MagnusThome/RejsaRubberTrac/3Dprint/images/main housing early wip 1.jpg

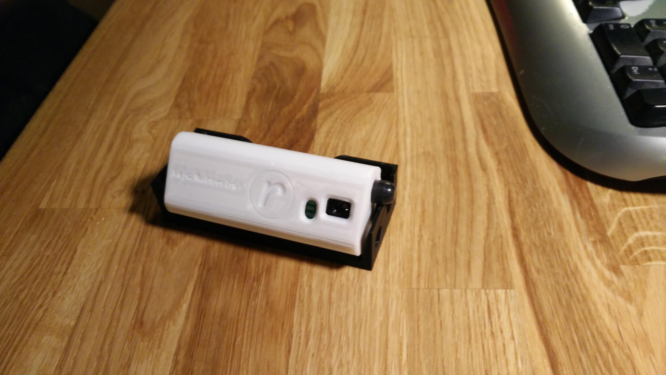
3Dprint/images/main housing early wip 1.jpg
