MagnusThome/RejsaRubberTrac/3Dprint/images/main housing early wip 2.jpg

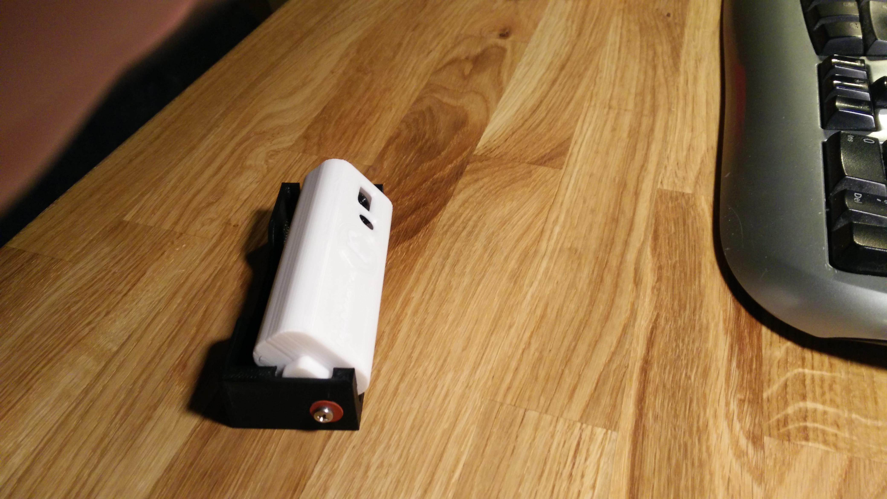
3Dprint/images/main housing early wip 2.jpg
