MagnusThome/RejsaRubberTrac/3Dprint/images/mainhousing.jpg

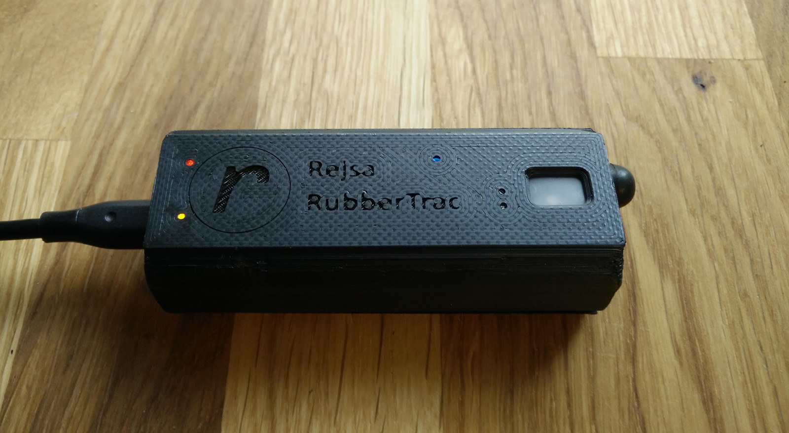
3Dprint/images/mainhousing.jpg
