MagnusThome/RejsaRubberTrac/images/harrys_early_preview.jpg

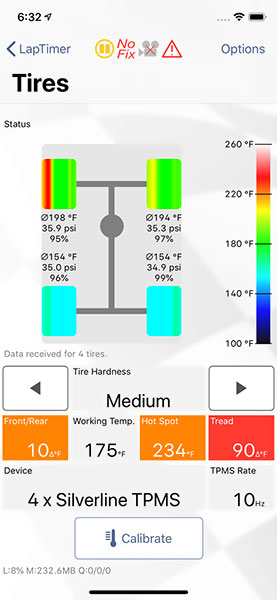
images/harrys_early_preview.jpg
