MagnusThome/RejsaRubberTrac/images/Racechrono beta video.png

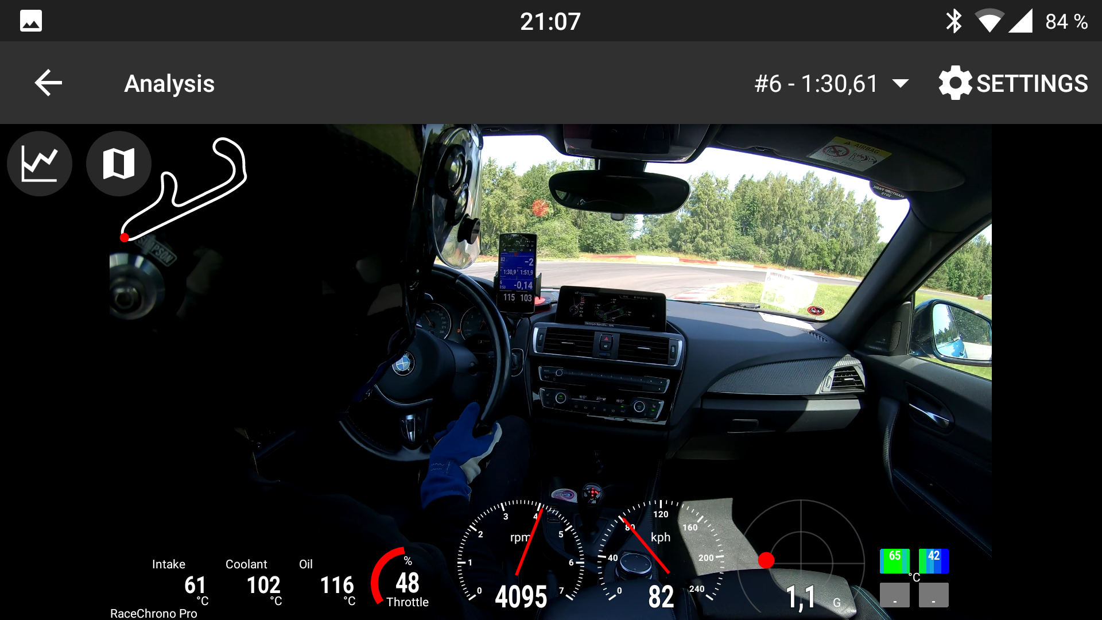
images/Racechrono beta video.png
