MagnusThome/RejsaRubberTrac/images/racechronostresstests.jpg

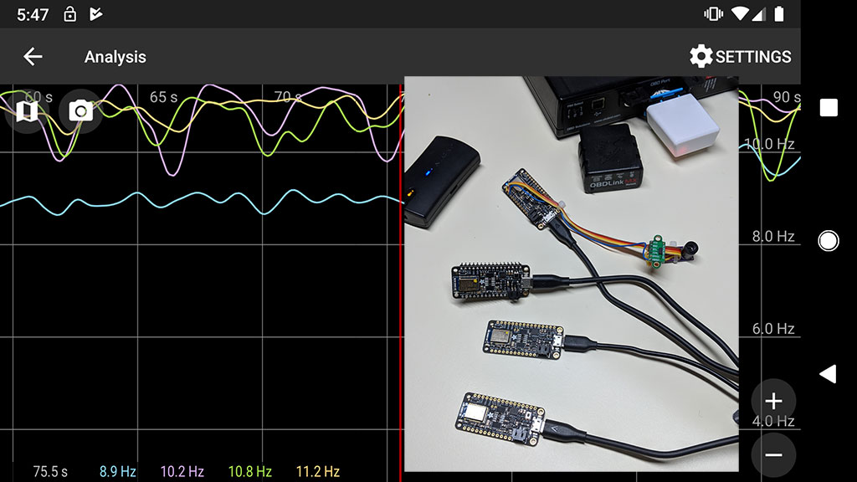
images/racechronostresstests.jpg
