MagnusThome/RejsaRubberTrac/pcb/Component list RejsaRubberTrac board v1.4 (2019-11-19).xlsx

 |  | PCB marking |  |  | Surface mount alternatives
Always needed
 | Adafruit Bluefruit nRF52 CPU/BLE board |  | https://www.mouser.se/ProductDetail/485-3406
 | 1x12 pin header, 2,54 mm | J4 | https://www.mouser.se/ProductDetail/200-TSW11205TS
 | 1x16 pin header, 2,54 mm | J5 | https://www.mouser.se/ProductDetail/200-TSW11605TS
 | 1x6 pin header, 2,54 mm | J1 | https://www.mouser.se/ProductDetail/200-TSW10607TS | For the sandwich mounting of temperature and distance sensor daugther boards.
 | 2x4 pin header, 2,54 mm | J6 | https://www.mouser.se/ProductDetail/200-TSW10407GD
 | Shunt jumpers |  | https://www.mouser.se/ProductDetail/806-SX1100-A | BUY FOUR OF THESE!
 | 1N4007 | D3 | https://www.mouser.se/ProductDetail/750-1N4007-G |  | https://www.mouser.se/ProductDetail/512-S1B
 | 1uF | C4 | https://www.mouser.se/ProductDetail/810-FG28X7R1E105KRT6 |  | https://www.mouser.se/ProductDetail/710-885012106022
 | MLX90621-ESF-BAB temp sensor | U2 | https://www.mouser.se/ProductDetail/482-90621ESFBAB000SP | This is the 60 degree field of view version. There is also a 120 degree version available. NOTE: The temperature sensor from Mouser in the link is without daughter board. You can also buy it with a daughter board from for example: https://www.aliexpress.com/w/wholesale-MLX90621.html?SortType=price_asc&SearchText=MLX90621 https://eckstein-shop.de/GY-906LLC-BAB-IR-Array-Temperature-Sensor-Module
Power switch |  |  |  | If you run your sensors without battery and use the car's 12V which is switched off itself you really don't need a power switch. But can still be useful to reset the device of course
 | PN12SHNA03QE (switch) | S1 | https://www.mouser.se/ProductDetail/611-PN12SHNA03QE
 | rubber seal |  | https://www.mouser.se/ProductDetail/608-1211-5
 | button top |  | https://www.mouser.se/ProductDetail/611-G003A
12V power
 | MC7805BDTRKG | U1 | https://www.mouser.se/ProductDetail/863-MC7805BDTRKG | Actually a surface mount version but it's pretty big so not hard to solder. Benefit is it's thin and fits between the boards.
 | Shottky | D1 | https://www.mouser.se/ProductDetail/583-1S40-T |  | https://www.mouser.se/ProductDetail/511-STPS1L30A
 | 1N4007 | D2 | https://www.mouser.se/ProductDetail/750-1N4007-G |  | https://www.mouser.se/ProductDetail/512-S1B
 | 1uF | C1 | https://www.mouser.se/ProductDetail/810-FG28X7R1E105KRT6 |  | https://www.mouser.se/ProductDetail/710-885012106022
 | 1uF | C2 | https://www.mouser.se/ProductDetail/810-FG28X7R1E105KRT6 |  | https://www.mouser.se/ProductDetail/710-885012106022
Distance sensor
 | VL53L0XV2 / VL53L0CX | U3 | https://www.ebay.com/sch/i.html?_nkw=vl53l0xv2&_sop=15 or https://www.aliexpress.com/w/wholesale-vl53l0xv2.html?SortType=price_asc&SearchText=vl53l0xv2 | Beware: There is now a version of this board that looks the same but that has moved around what is connected to what pin. The order of pins (look carefully at the product picture on the page where you order) must be: - VIN - GND - SCL - SDA - GPIO - XSHUT
Different battery choices
 | Flat Li-Po rechargeable battery (JSP-PH 2.0 mm connector) |  | https://www.ebay.com/sch/i.html?_nkw=3.7V+lipo+battery+JST-PH+2.0&_sop=15 | The size "503035" fits in the 3D-printed housing but is a bit big capacity and size wise lasting 24 hours straight (500mAh). So you can choose smaller if you want.
 | 1x2 pin header, 2,54 mm | J2 | https://www.mouser.se/ProductDetail/200-TSW10207GS | Only needed if you have a battery with a 2.54 mm connector plug instead if the already present JST-PH 2.0 mm one.
 | 1x2 pin header, 1,27 mm | J3 | https://www.mouser.se/ProductDetail/200-FTS10201FS | Only needed if you have a battery with a 1.27 mm connector plug instead if the already present JST-PH 2.0 mm one.
 | Using AA or AAA battery size Li-Ions (not actual 1,5V batteries!!) instead of the above flat Li-Po battery one takes a lot of space on the rear side of the board
 | Li-ion battery holder AA | on rear side | https://www.mouser.se/ProductDetail/534-1087 | Only needed if you want to use a AA size Li-Ion rechargeable battery
 | Li-ion battery holder AAA | on rear side | https://www.mouser.se/ProductDetail/534-1075 | Only needed if you want to use a AAA size Li-Ion rechargeable battery
 | AAA size Li-ion rechargeable battery |  | https://www.ebay.com/sch/i.html?_nkw=li-ion+3.7V+aaa+10440&_sop=15
 | AA size Li-ion rechargeable battery |  | https://www.ebay.com/sch/i.html?_nkw=li-ion+3.7V+aa+14500&_sop=15
Changes
1.1 | Published on Github
1.2 | Added link to temperature sensors WITH daughter board
1.3 | Corrected Mouser part number for switch rubber seal
1.4 | Added warning about distance sensor board with wrong board pinout
