MagnusThome/RejsaRubberTrac/3Dprint/printables/Main Housing (CONE for dist. sens.).step

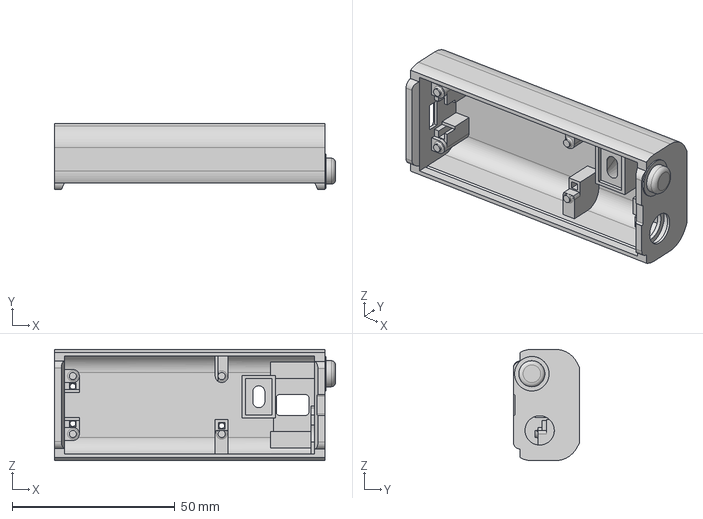
[picture p47: CAD file, 2023-02-16]
3Dprint/printables/Main Housing (CONE for dist. sens.).step
86.3 x 20.4 x 34.2 mm
