MagnusThome/RejsaRubberTrac/3Dprint/printables/Main Housing (ALT. temp sensor mounting).step

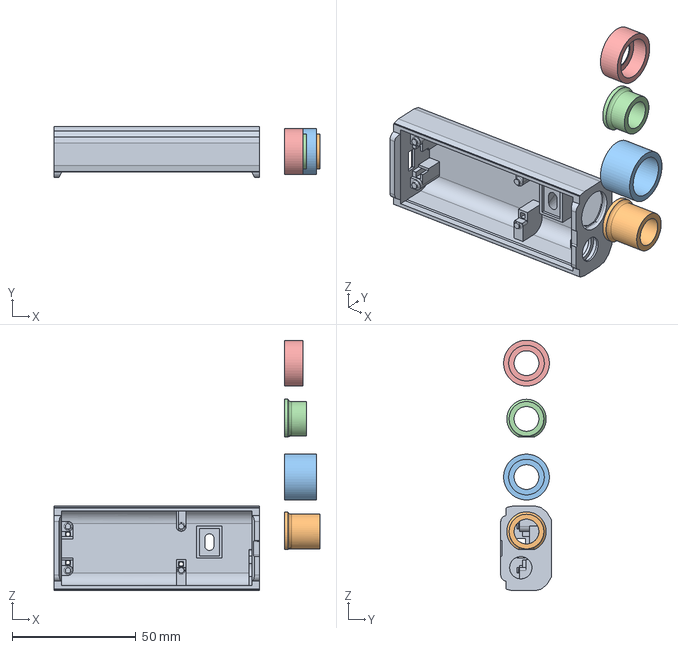
[picture p48: CAD file, 2023-02-16]
3Dprint/printables/Main Housing (ALT. temp sensor mounting).step
107.4 x 20.4 x 101.1 mm
