MagnusThome/RejsaRubberTrac/3Dprint/printables/Main Housing Lid LEFT REAR.stl

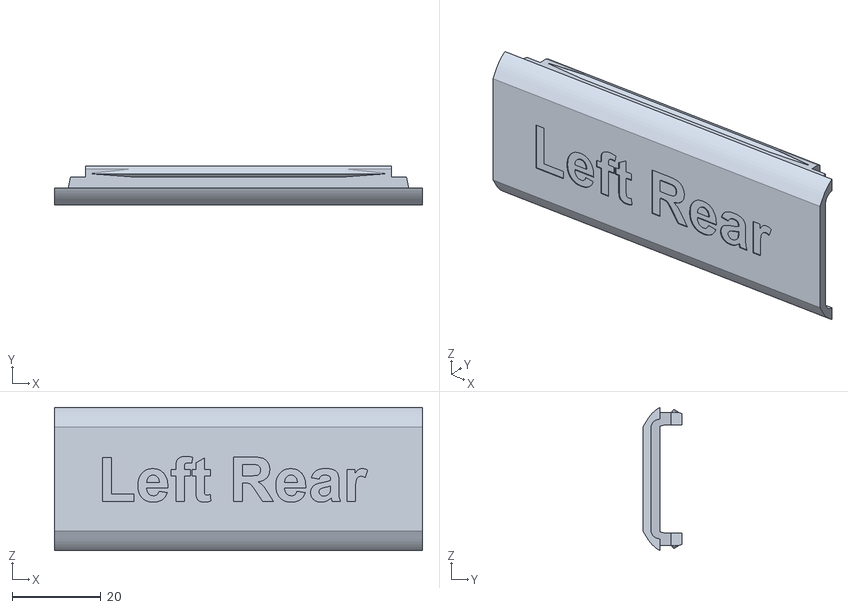
[picture p49: CAD file, 2020-07-22]
3Dprint/printables/Main Housing Lid LEFT REAR.stl
83.0 x 8.90 x 32.4
