MagnusThome/RejsaRubberTrac/3Dprint/printables/Main Housing Lid NO TEXT.stl

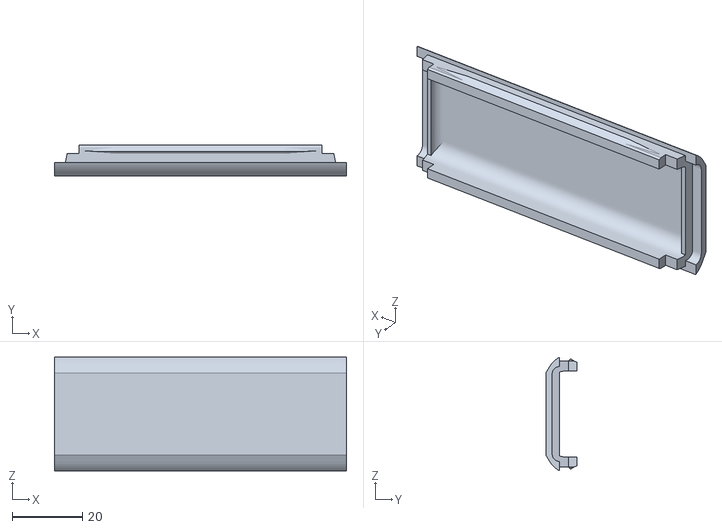
[picture p50: CAD file, 2020-07-22]
3Dprint/printables/Main Housing Lid NO TEXT.stl
83.0 x 8.90 x 32.4
