MagnusThome/RejsaRubberTrac/3Dprint/printables/Main Housing (ALT. temp sensor mounting) Base.stl

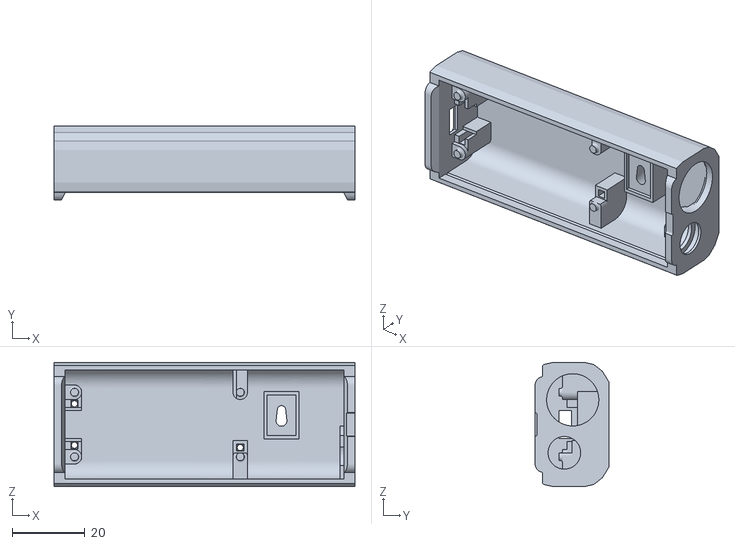
[picture p51: CAD file, 2019-10-04]
3Dprint/printables/Main Housing (ALT. temp sensor mounting) Base.stl
83.0 x 20.4 x 34.2
