MagnusThome/RejsaRubberTrac/3Dprint/printables/Main Housing (ALT. temp sensor mounting) Sensor mountings.stl

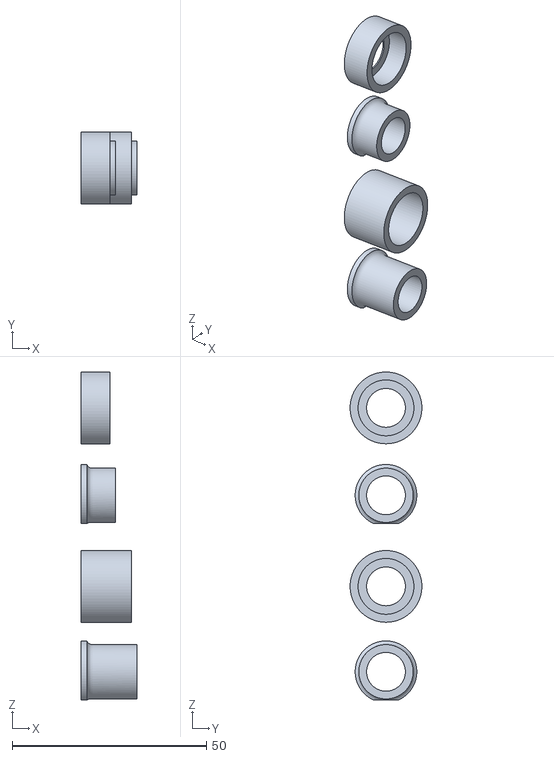
[picture p52: CAD file, 2019-09-29]
3Dprint/printables/Main Housing (ALT. temp sensor mounting) Sensor mountings.stl
14.4 x 18.5 x 84.5
