MagnusThome/RejsaRubberTrac/3Dprint/printables/Main Housing USB Lid.stl

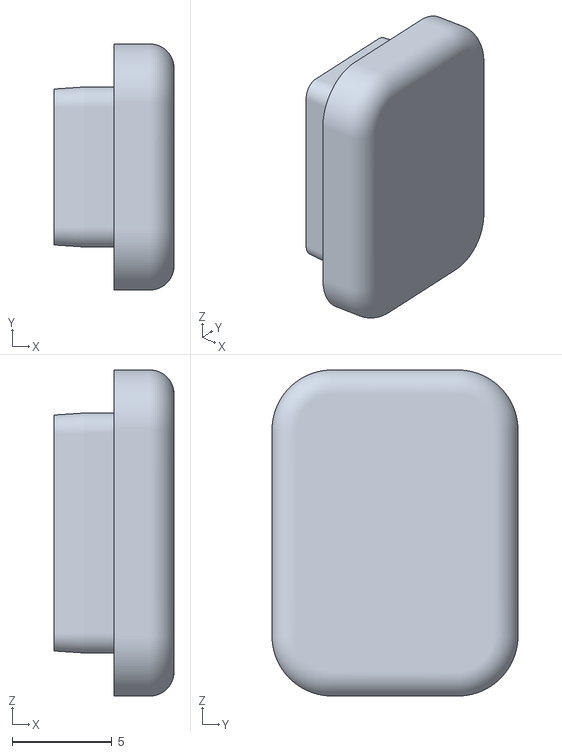
[picture p53: CAD file, 2019-03-17]
3Dprint/printables/Main Housing USB Lid.stl
6.00 x 12.3 x 16.3
