MagnusThome/RejsaRubberTrac/3Dprint/printables/Snap-in holder (Inner fender for BMW M2) v12.step

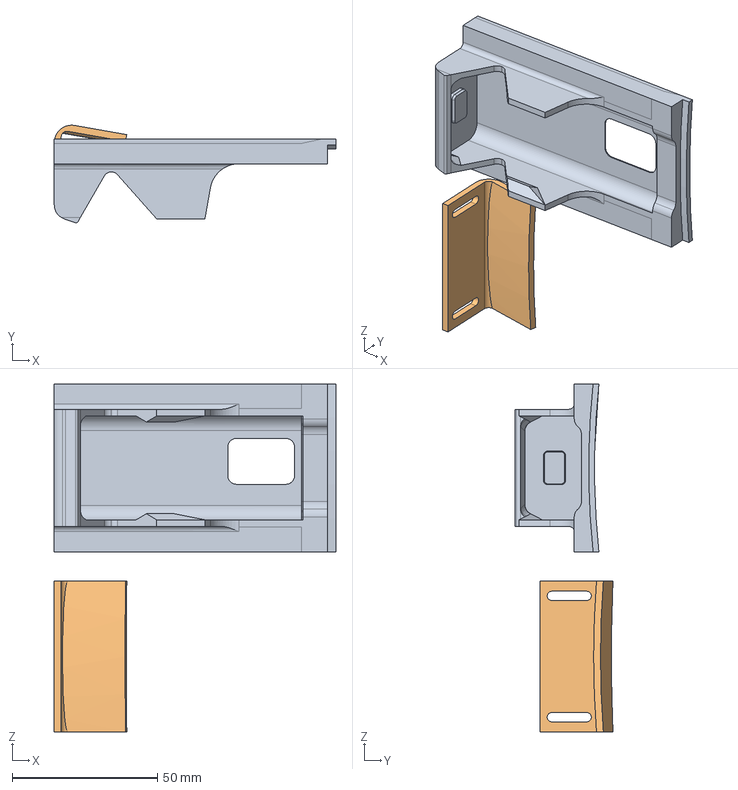
[picture p54: CAD file, 2020-07-28]
3Dprint/printables/Snap-in holder (Inner fender for BMW M2) v12.step
97.0 x 33.6 x 119.9 mm
