MagnusThome/RejsaRubberTrac/3Dprint/printables/Snap-in holder (Inner fender for BMW M2) Bracket.stl

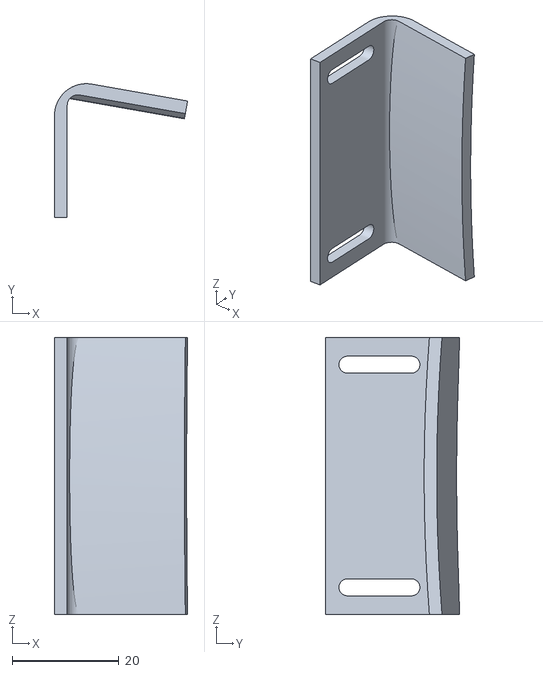
[picture p55: CAD file, 2020-07-28]
3Dprint/printables/Snap-in holder (Inner fender for BMW M2) Bracket.stl
25.0 x 25.1 x 52.0
