MagnusThome/RejsaRubberTrac/3Dprint/printables/Snap-in holder (Inner fender for BMW M2) Base.stl

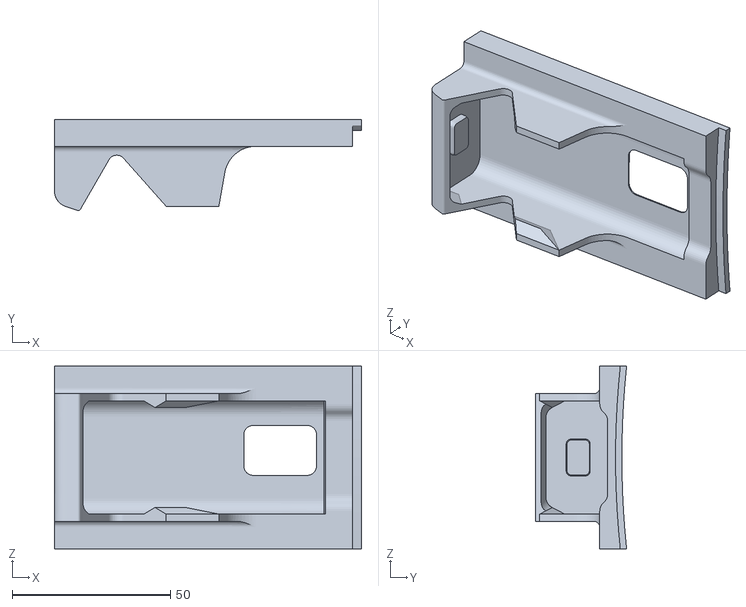
[picture p56: CAD file, 2020-07-28]
3Dprint/printables/Snap-in holder (Inner fender for BMW M2) Base.stl
97.0 x 28.8 x 57.8
