MagnusThome/RejsaRubberTrac/3Dprint/printables/Snap-in holder (Under Car).stl

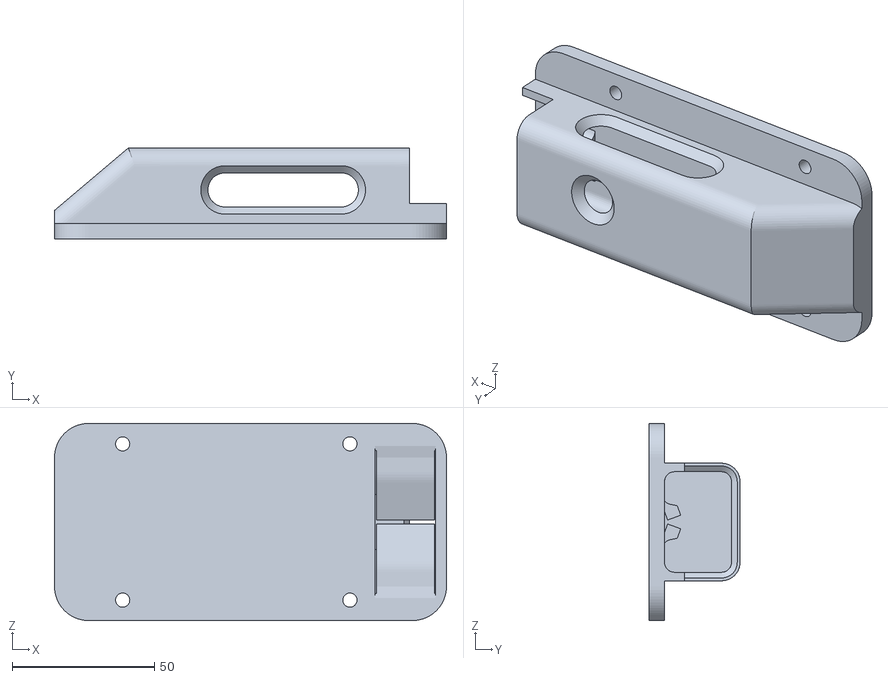
[picture p57: CAD file, 2019-10-05]
3Dprint/printables/Snap-in holder (Under Car).stl
138.0 x 32.1 x 69.4
