MagnusThome/RejsaRubberTrac/3Dprint/printables/Minisensor v2.step

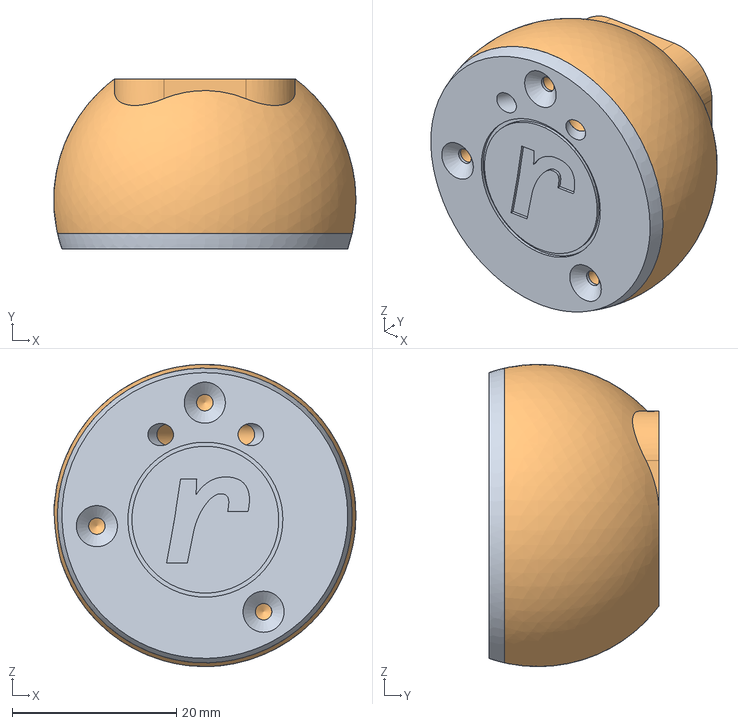
[picture p58: CAD file, 2019-10-02]
3Dprint/printables/Minisensor v2.step
36.8 x 20.8 x 36.8 mm
