MagnusThome/RejsaRubberTrac/3Dprint/printables/Snap-in holder (Hinged) v17.step

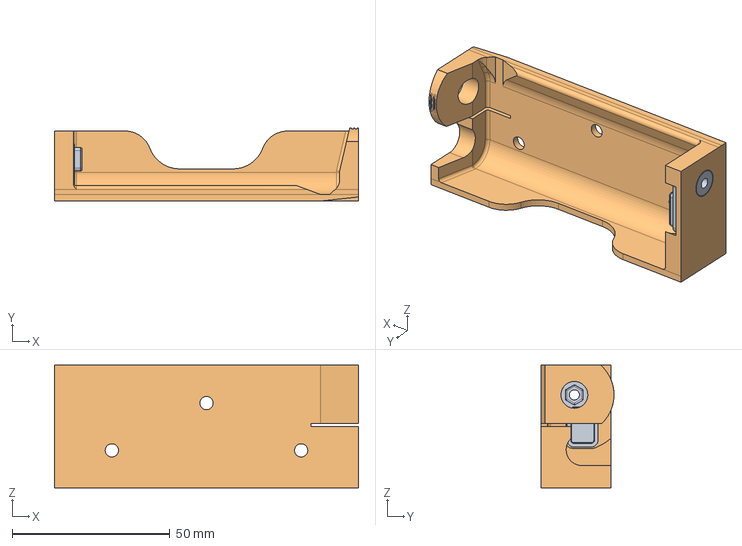
[picture p59: CAD file, 2019-10-02]
3Dprint/printables/Snap-in holder (Hinged) v17.step
96.3 x 23.2 x 38.9 mm
