MagnusThome/RejsaRubberTrac/3Dprint/printables/Temperature Sensor Mounting Spacer 5,5mm.stl

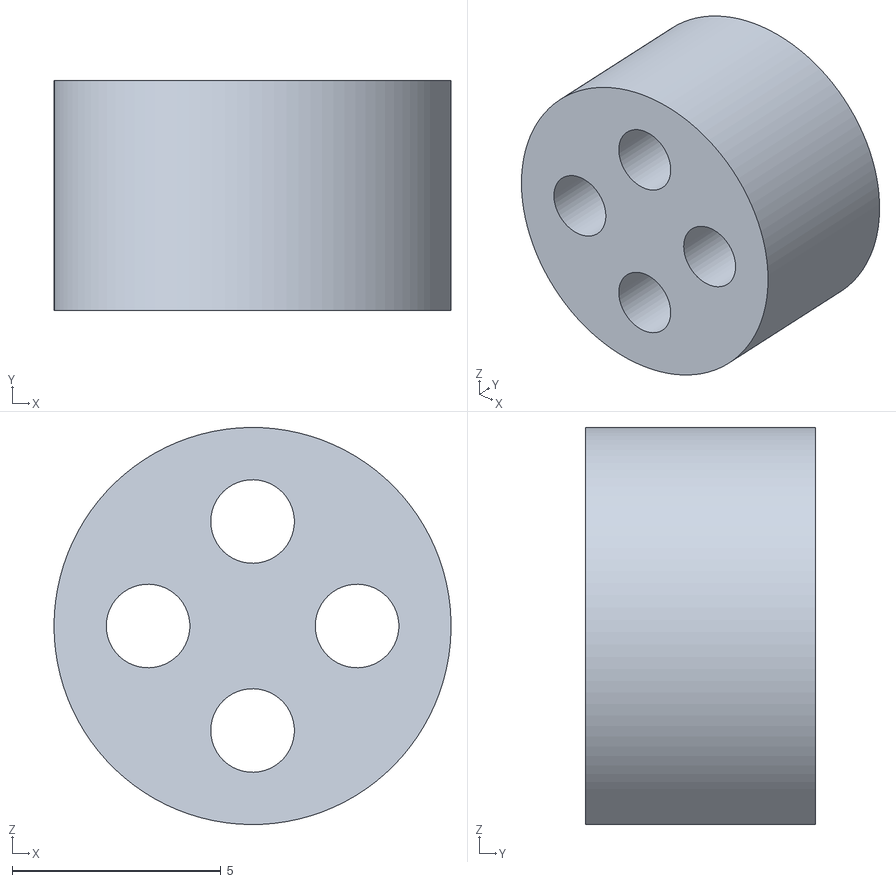
[picture p60: CAD file, 2019-09-28]
3Dprint/printables/Temperature Sensor Mounting Spacer 5,5mm.stl
9.50 x 5.50 x 9.50
