MagnusThome/RejsaRubberTrac/3Dprint/printables/Snap-in holder (Hinged) Base.stl

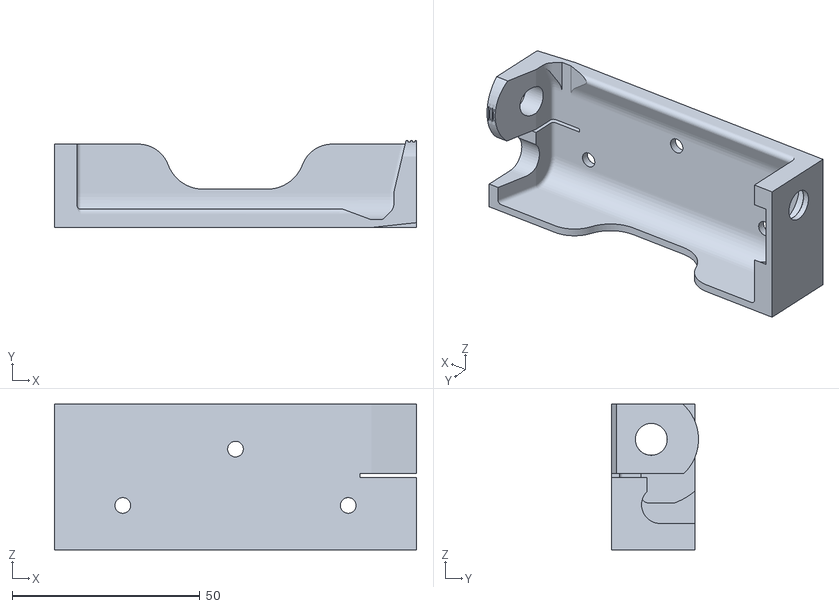
[picture p61: CAD file, 2019-09-27]
3Dprint/printables/Snap-in holder (Hinged) Base.stl
96.4 x 23.2 x 38.9
