MagnusThome/RejsaRubberTrac/3Dprint/printables/Snap-in holder (Hinged) Hinge.stl

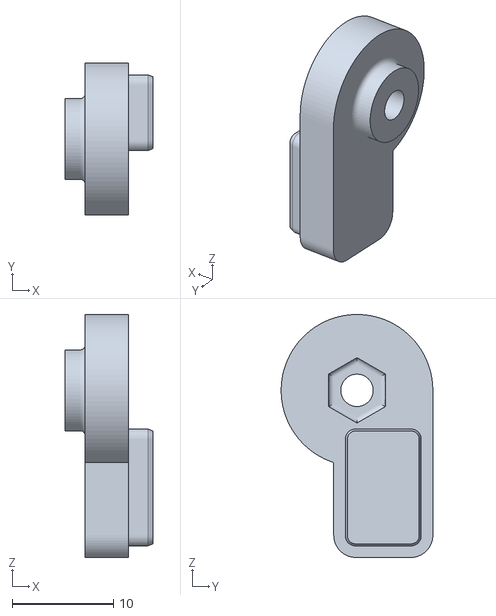
[picture p62: CAD file, 2019-09-27]
3Dprint/printables/Snap-in holder (Hinged) Hinge.stl
8.70 x 15.0 x 24.0
