MagnusThome/RejsaRubberTrac/3Dprint/printables/Carrying Case.stl

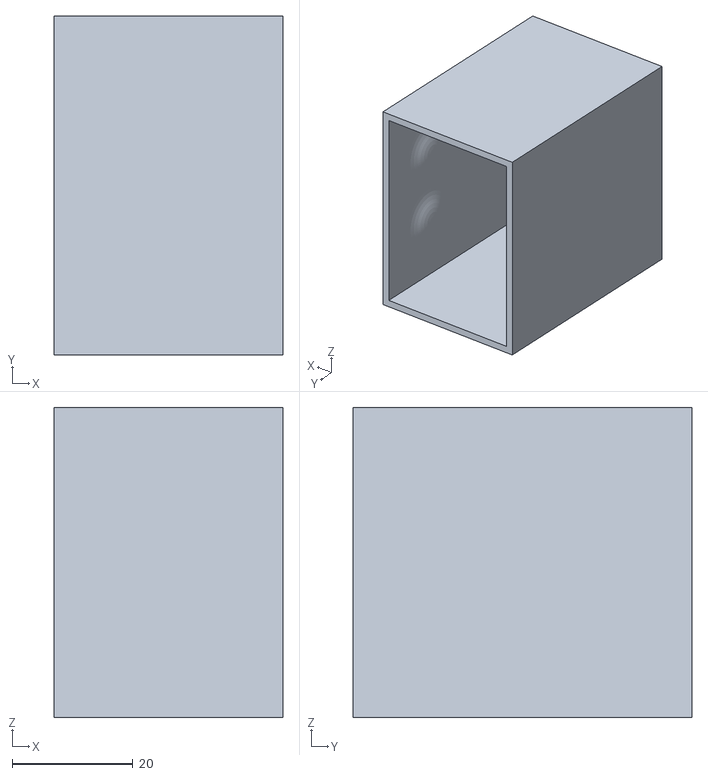
[picture p63: CAD file, 2019-08-29]
3Dprint/printables/Carrying Case.stl
37.9 x 56.2 x 51.4
