MagnusThome/RejsaRubberTrac/3Dprint/printables/Minisensor Holder Ring.stl

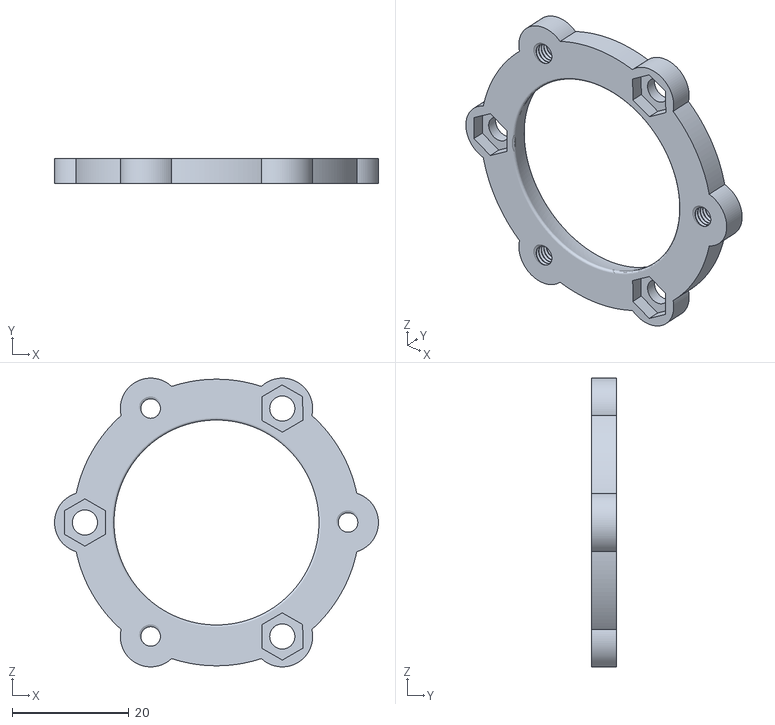
[picture p64: CAD file, 2019-04-29]
3Dprint/printables/Minisensor Holder Ring.stl
55.4 x 4.20 x 49.4
