MagnusThome/RejsaRubberTrac/3Dprint/printables/Minisensor Base.stl

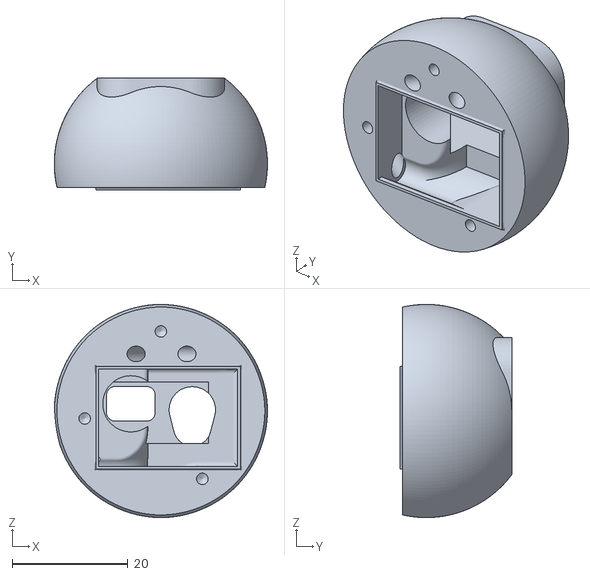
[picture p65: CAD file, 2019-04-29]
3Dprint/printables/Minisensor Base.stl
36.8 x 19.3 x 36.8
