MagnusThome/RejsaRubberTrac/3Dprint/printables/Minisensor Lid.stl

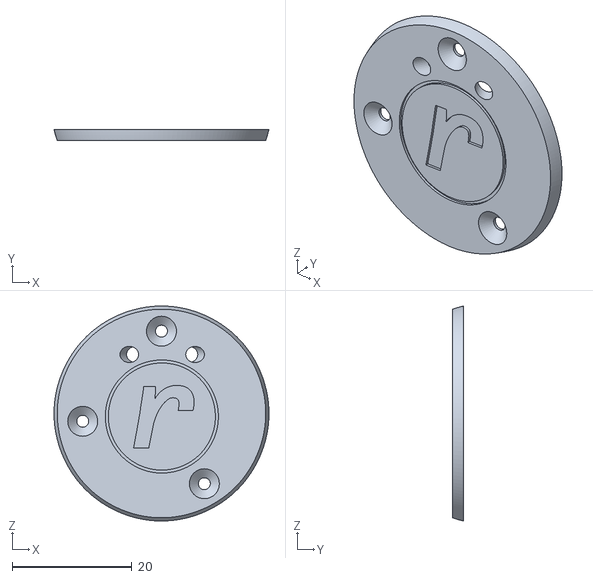
[picture p66: CAD file, 2019-04-29]
3Dprint/printables/Minisensor Lid.stl
35.9 x 1.90 x 35.9
