MagnusThome/RejsaRubberTrac/3Dprint/printables/Temperature Sensor Mounting Spacer 10mm.stl

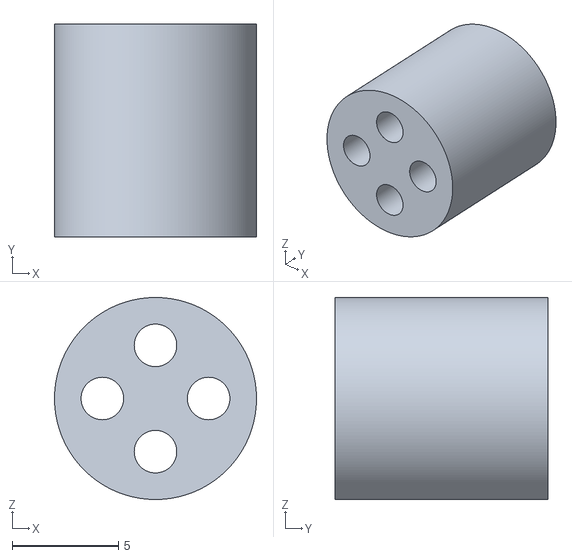
[picture p67: CAD file, 2019-03-13]
3Dprint/printables/Temperature Sensor Mounting Spacer 10mm.stl
9.50 x 10.0 x 9.50
