MagnusThome/RejsaRubberTrac/3Dprint/printables/Temperature Sensor Mounting Spacer 3,5mm.stl

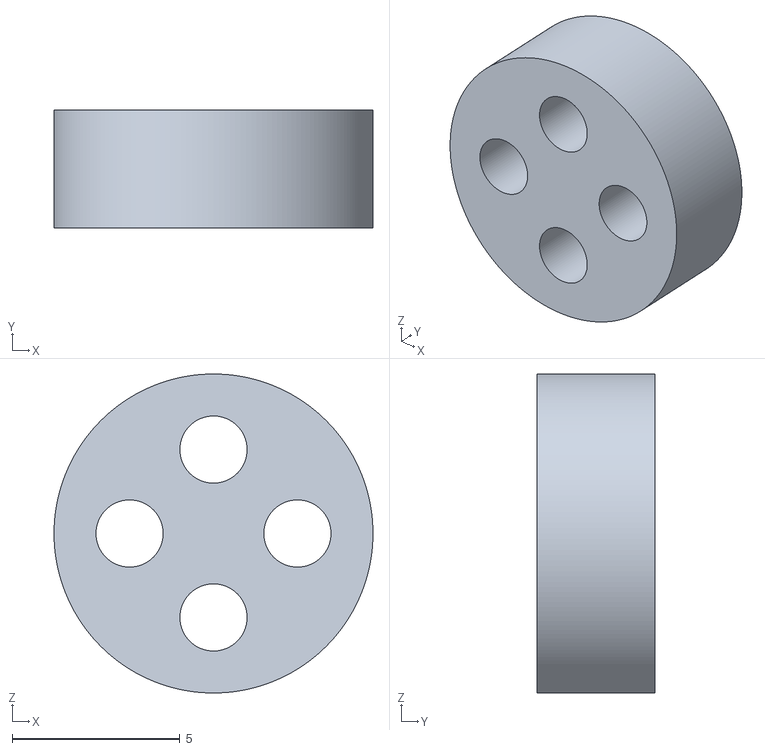
[picture p68: CAD file, 2019-03-13]
3Dprint/printables/Temperature Sensor Mounting Spacer 3,5mm.stl
9.50 x 3.50 x 9.50
