MagnusThome/RejsaRubberTrac/(list of files, cad)

Other CAD files:
3Dprint/printables/Main Housing Lid RIGHT REAR.stl
3Dprint/printables/Main Housing Lid RIGHT FRONT.stl
3Dprint/printables/Main Housing Lid LEFT FRONT.stl
3Dprint/printables/Main Housing Base.stl.stl
3Dprint/printables/Snap-in holder (Under Car) nut holder.stl
