MagnusThome/RejsaRubberTrac/3Dprint/printables/README.md

# Files for 3D printing
- STL files for 3D printing
- STEP files for import to 3D CAD programs for editing

You can always click on the STL files here and get a 3D view of the model!
