MagnusThome/RejsaRubberTrac/installArduino.md

# Install Arduino IDE to compile and upload the code

- Download and install the Arduino IDE 
https://www.arduino.cc/en/Main/Software
  
- Start Arduino IDE, choose "File" > "Preferences" and copy this line below into the "Additional Boards Manager URLs" field

  ```https://adafruit.github.io/arduino-board-index/package_adafruit_index.json```  
  
<img hspace="50" src="images/installArduinoIDE-0.gif">

- Go to "Boards Manager"

<img hspace="50" src="images/installArduinoIDE-1.gif">

- Enter "nRF52" in the search box and then install "Adafruit nRF52 Boards". This will take a while to complete...

<img hspace="50" src="images/installArduinoIDE-2.gif">

- Choose "Adafruit Bluefruit nRF52832 Feather"

<img hspace="50" src="images/installArduinoIDE-3.gif">

- Go to "Manage Libraries"

<img hspace="50" src="images/installArduinoIDE-4.gif">

- Enter "vl53" in the search box and then install "VL53L0X by __Polulu__" 

<img hspace="50" src="images/installArduinoIDE--5.gif">

- Connect the Adafruit Bluefruit board to your computer's USB and choose the corresponding COM port

<img hspace="50" src="images/installArduinoIDE-6.gif">

- Place all the files downloaded from here https://github.com/MagnusThome/RejsaRubberTrac/tree/master/main in a directory called "main"

- Open the main.ino file and choose "Upload"  

Note: Make sure the board is turned on if you have a power switch mounted on the board. Yes, been there, done that...

<img hspace="50" src="images/installArduinoIDE-7b.gif">

- If you get error messages when trying to upload first check that you've chosen the correct COM port number and that the board is connected properly.  

- If you get error messages looking something like this below (and you are sure you are using the correct COM port) you need to update the bootloader to a newer version, follow the guide on the link below.  
`File "nordicsemi\dfu\dfu_transport_serial.py", line 243, in send_packet`  
`File "nordicsemi\dfu\dfu_transport_serial.py", line 282, in get_ack_nr`  
`nordicsemi.exceptions.NordicSemiException: No data received on serial port. Not able to proceed.`  
https://learn.adafruit.com/bluefruit-nrf52-feather-learning-guide/updating-the-bootloader

- When done you can open the "Serial Monitor" under the "Tools" menu and view the Arduino board's status and data transmitted. Temperatures are in degrees celsius times ten.

<img src="images/usbterminal.PNG">

- Have fun!
