MagnusThome/RejsaRubberTrac/images/installArduinoIDE-0.gif

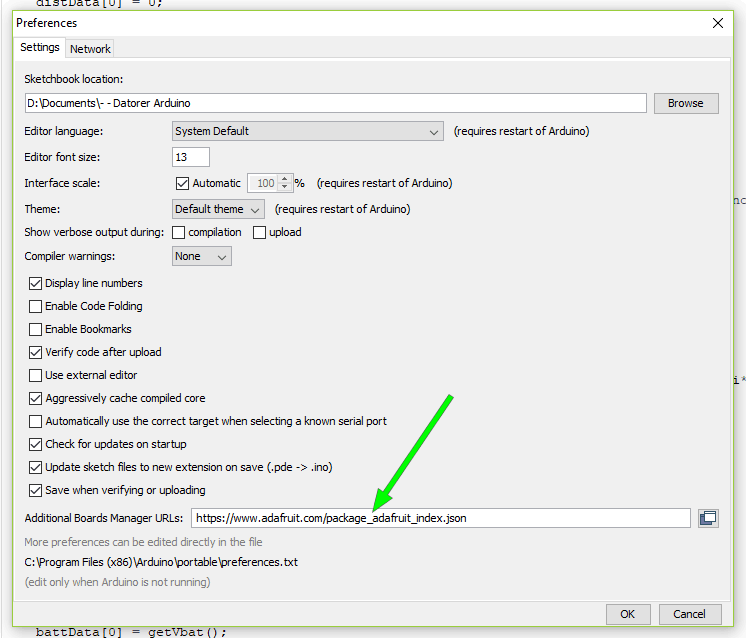
images/installArduinoIDE-0.gif
