MagnusThome/RejsaRubberTrac/images/installArduinoIDE-1.gif

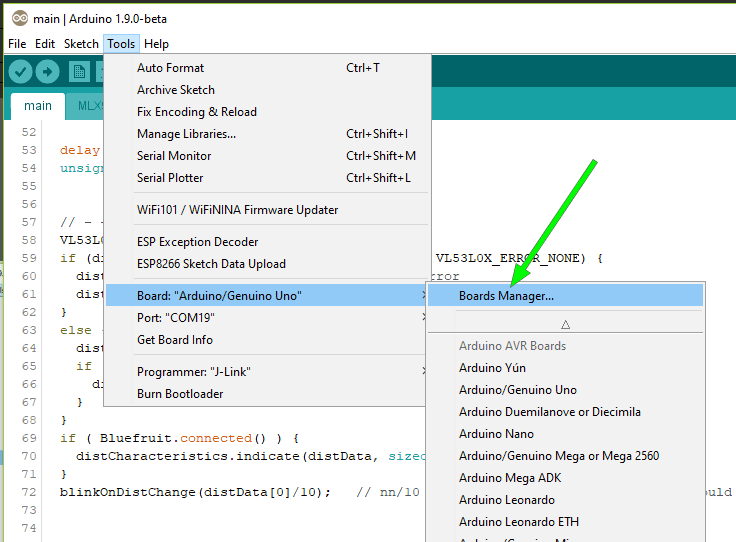
images/installArduinoIDE-1.gif
