MagnusThome/RejsaRubberTrac/images/installArduinoIDE-2.gif

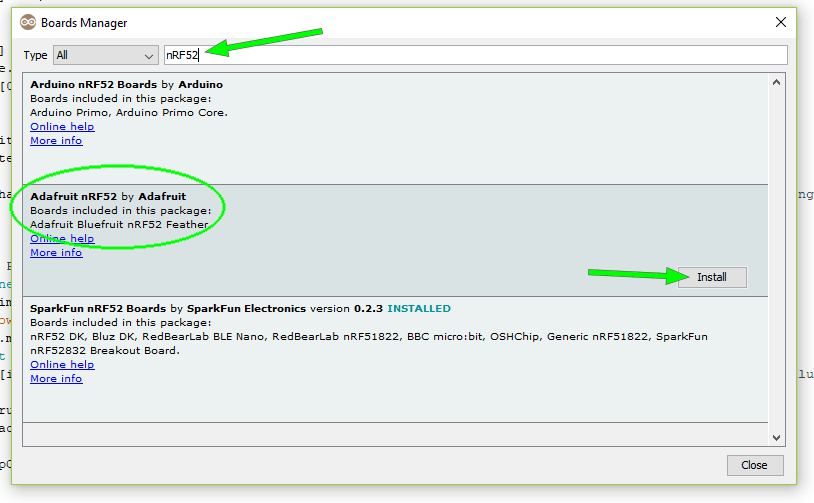
images/installArduinoIDE-2.gif
