MagnusThome/RejsaRubberTrac/images/installArduinoIDE-3.gif

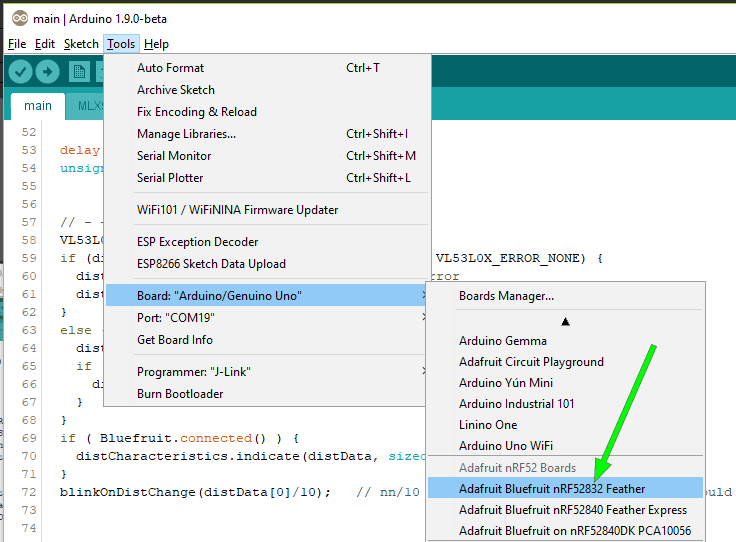
images/installArduinoIDE-3.gif
