MagnusThome/RejsaRubberTrac/images/installArduinoIDE-4.gif

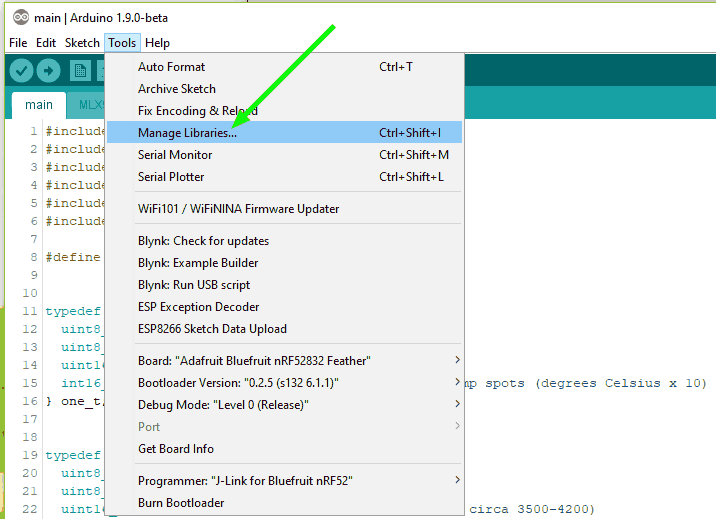
images/installArduinoIDE-4.gif
