MagnusThome/RejsaRubberTrac/images/installArduinoIDE-5.gif

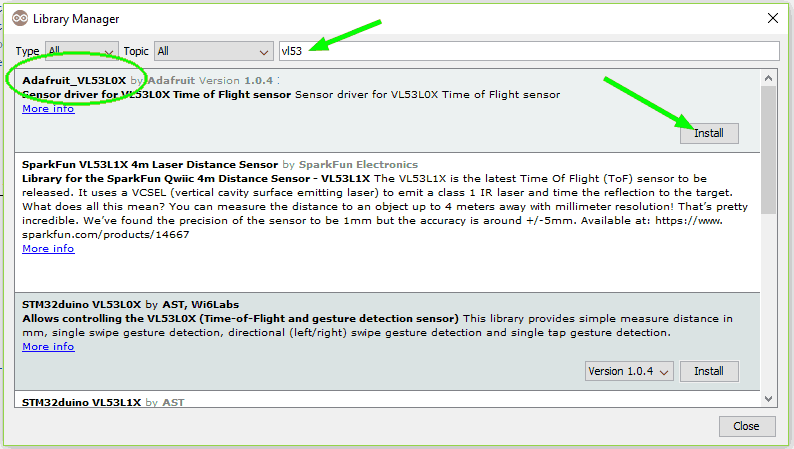
images/installArduinoIDE-5.gif
