MagnusThome/RejsaRubberTrac/images/installArduinoIDE-6.gif

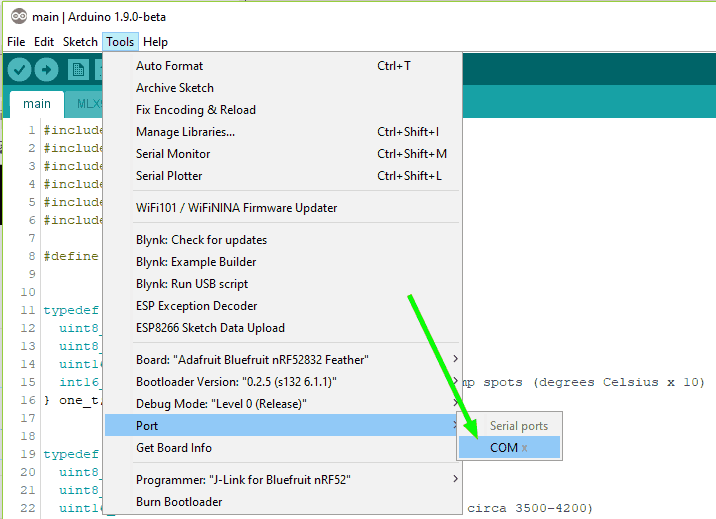
images/installArduinoIDE-6.gif
