MagnusThome/RejsaRubberTrac/images/installArduinoIDE-7b.gif

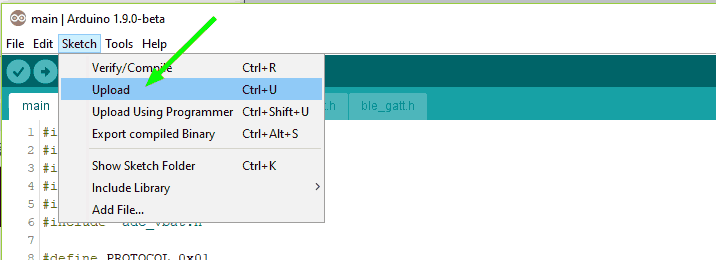
images/installArduinoIDE-7b.gif
