MagnusThome/RejsaRubberTrac/(list of files, drawings)

Other design files:
pcb/rubber1.2.dip
