MagnusThome/RejsaRubberTrac/(commit log)

2019-01-16 Added stability by reseting dist sensor
    A cable from GPIO pin 27 on Bluefruit to distance sensor pin XSHUT prevents most of its hangs. Not all though. Disconnecting and reconnecting the sensor during running can still hang the loop.
    [main.ino]
2019-01-16 Added "reset" cable to distance sensor
2019-01-16 Added cable in connection drawing
2019-01-16 added extra cable to distance sensor
2019-01-16 Boot check if dist sensor missing
    If distance sensor is missing at boot it is disabled and not read/checked/restarted.
    Speed of temperature readings increases if the distance sensor is missing and disabled from boot.
    [main.ino]
2019-01-17 Added part of MAC to BLE name
    So each device has a unique name (not 100% unique though but...)
2019-01-18 Added choices of wheel ID
2019-01-18 Added choice of wheel location in ble name
2019-01-18 comments on fixed or unique device names
2019-01-18 Added image of sensor positioning
2019-01-18 added picture of sanwiching the two sensorboards
2019-01-19 Dummy temps where too low
    [dummydata.h]
2019-01-22 Changed tire position naming scheme
2019-01-22 Tire positon naming scheme changed
2019-01-27 comment on device name wheel position code
2019-01-28 lowered mV steps
    lowered mV steps to prevent showing false 99% charge when on USB power
    [adc_vbat.h]
2019-01-28 added comment + lowered LED power draw
2019-01-28 false alarm on mV, reverted
    [adc_vbat.h]
2019-02-02 HW coding of wheel pos + Tire mirroring
2019-02-10 adjusted battery voltage range
2019-03-05 Info on PCB!
2019-03-06 info on non daughter board temp sensor
2019-03-09 LED showing Bluetooth connection status added
2019-03-13 3D print info
2019-04-16 LEDs blink changed AND temp scaling+offset
2019-04-25 New third GATT with averaged 8 values from all 16 sensor spots
2019-05-05 fixed bug in dummydata
    [dummydata.h]
2019-06-09 Larger holes for distance sensor
    [Main Housing Base.stl, Main Housing Lid.stl, Main Housing.step]
2019-06-11 Adjusted holes for distance sensor
    [Main Housing Base.stl, Main Housing.step]
2019-07-01 Changed protocol to v.0x02
    - Distance is signed int instead of unsigned
    - Distance has offset define
    - Distance is slightly filtered to reduce noise somewhat
    [main.ino]
2019-08-07 added cut down sensor daughter board info
2019-09-07 Small ridge and slot to keep lid stuck better
    [Main Housing (CONE for distance sensor).step, Main Housing Base (CONE for distance sensor).stl, Main Housing Lid LEFT FRONT.stl, Main Housing Lid LEFT REAR.stl, Main Housing Lid NO TEXT.stl, Main Housing Lid RIGHT FRONT.stl, Main Housing Lid RIGHT REAR.stl]
2019-09-23 Corrected push button rubber seal
    [Component list RejsaRubberTrac board v1.3 (2019-09-23).xlsx]
2020-07-19 Add files via upload
    Slightly larger hole for distance sensor
    [Main Housing Base.stl.stl]
2020-07-22 Better snap close
    [Main Housing Lid LEFT FRONT.stl, Main Housing Lid LEFT REAR.stl, Main Housing Lid NO TEXT.stl, Main Housing Lid RIGHT FRONT.stl, Main Housing Lid RIGHT REAR.stl]
2021-10-15 Racechrono needs tire position
2023-06-12 DipTrace PCB file
    [rubber1.2.dip]
